knielsen/stm32f0_experiment_pcb/gerbers_rev1/pcb_f0test.txt

M48
;DRILL file {KiCad (2016-07-22 BZR 6991, Git 146a78a)-product} date Tue Jul 26 18:11:16 2016
;FORMAT={-:-/ absolute / inch / decimal}
FMAT,2
INCH,TZ
T1C0.012
T2C0.026
T3C0.028
T4C0.028
T5C0.031
T6C0.040
%
G90
G05
M72
T1
X1.169Y-1.9402
X1.1779Y-1.9802
X1.2283Y-0.8858
X1.2343Y-2.4047
X1.2463Y-2.083
X1.2464Y-1.7382
X1.2646Y-1.9784
X1.2663Y-1.9432
X1.2939Y-2.3753
X1.2953Y-1.1772
X1.2961Y-1.8431
X1.3305Y-2.3919
X1.378Y-1.252
X1.3937Y-0.9764
X1.3965Y-2.3731
X1.4047Y-2.5531
X1.4331Y-1.252
X1.4449Y-2.0512
X1.4582Y-2.5079
X1.4626Y-0.9645
X1.4646Y-1.1339
X1.4653Y-2.4752
X1.4744Y-2.5348
X1.4748Y-2.3744
X1.5056Y-2.3698
X1.5061Y-2.5536
X1.5392Y-2.4665
X1.5413Y-2.3636
X1.5433Y-2.5045
X1.561Y-2.5576
X1.5786Y-2.5026
X1.5797Y-2.3626
X1.5799Y-2.4309
X1.6004Y-2.5576
X1.6145Y-2.4279
X1.6808Y-2.484
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
