knielsen/stm32f0_experiment_pcb/pcb_f0test.kicad_pcb

## KiCad design pcb_f0test.kicad_pcb (2016-07-26)

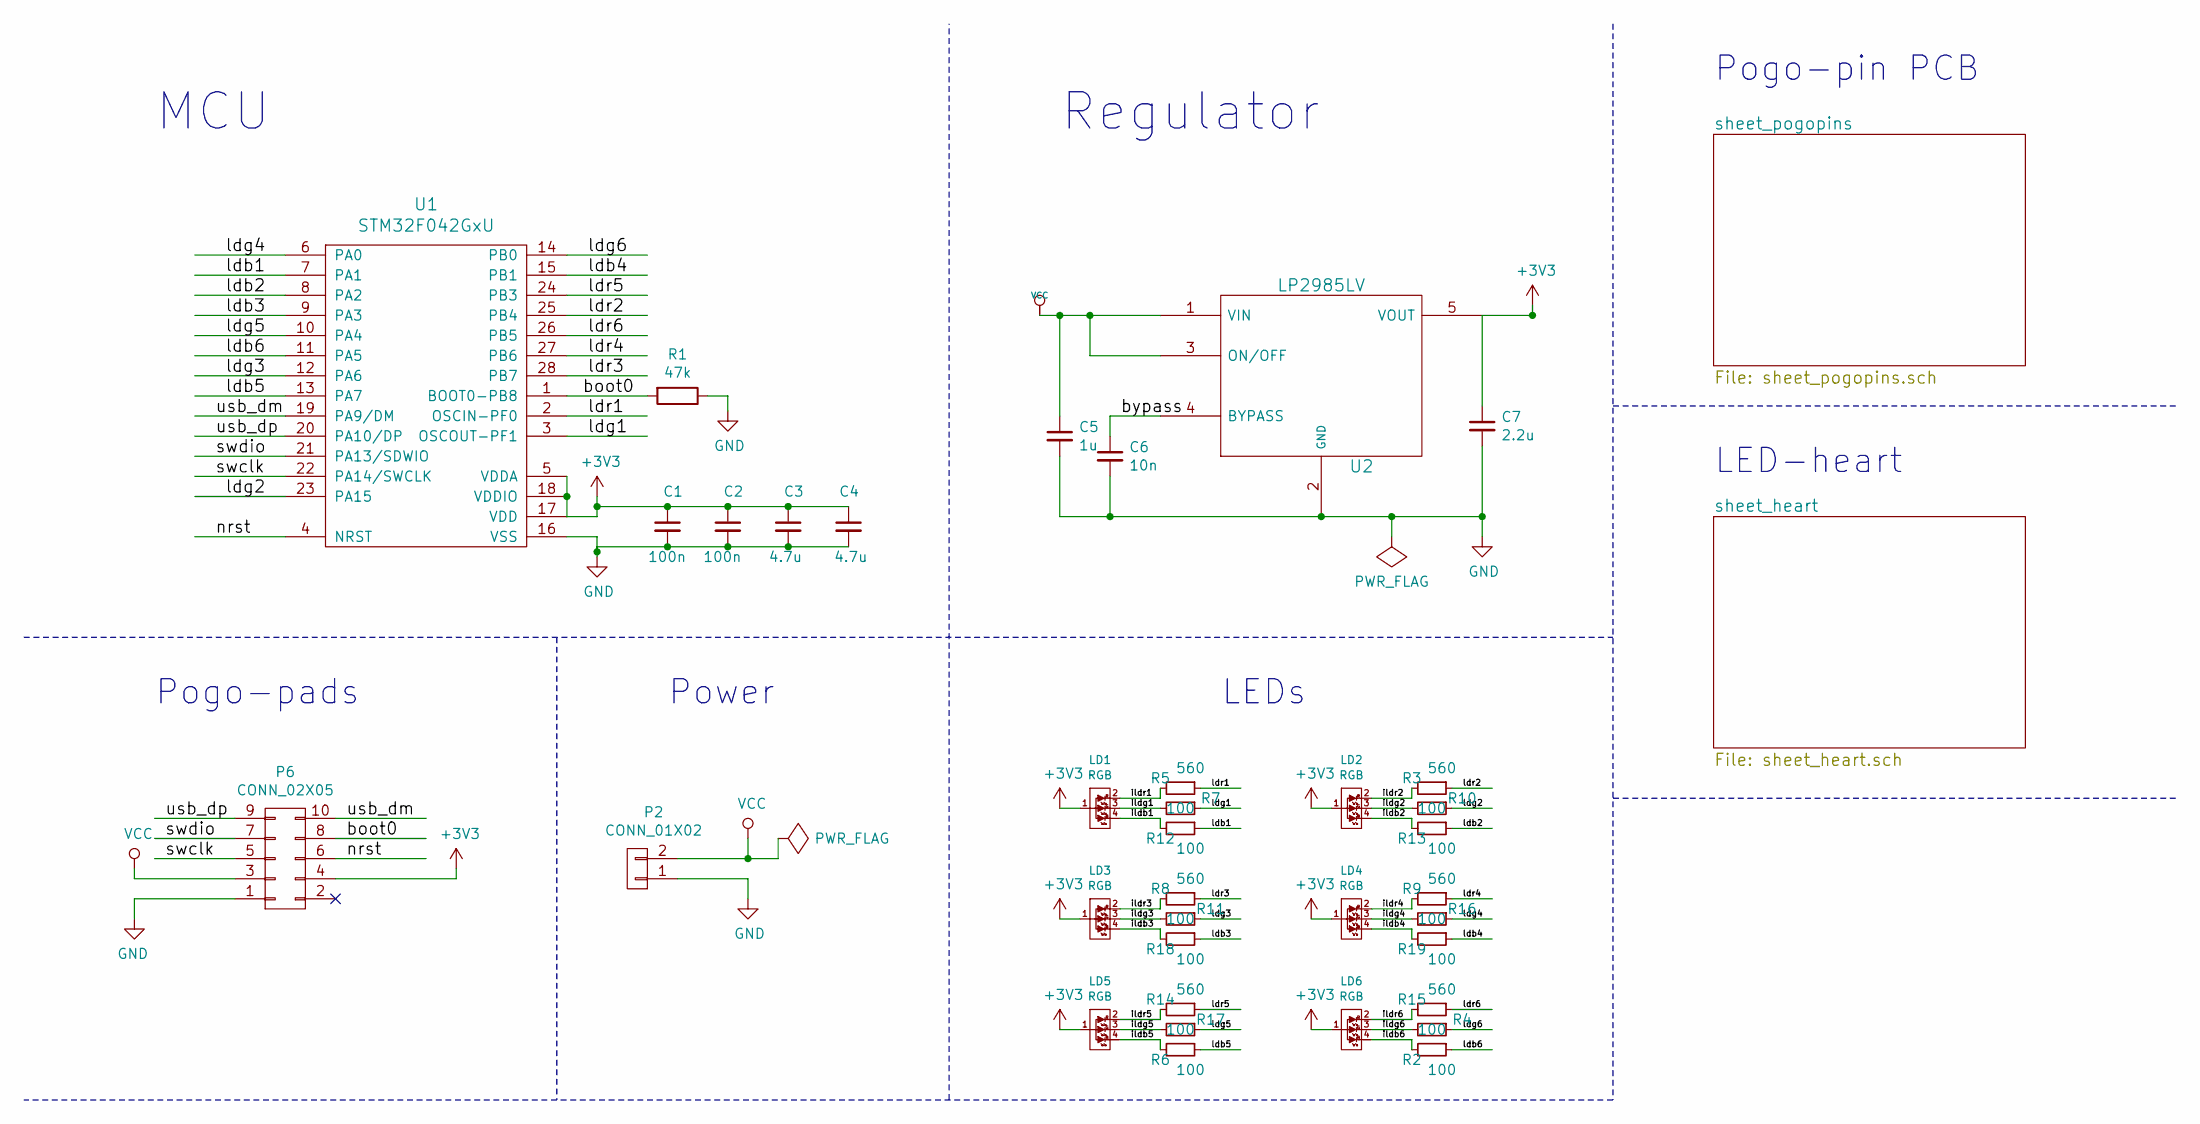
[picture p1: schematic pcb_f0test.sch]

Parts:
C1, C2: 100n; C_0603
C3, C4: 4.7u; C_0603
C5: 1u; C_0603
C6: 10n; C_0603
C7: 2.2u; C_0603
LD1, LD2, LD3, LD4, LD5, LD6: RGB; RGB_0603_ALTPINOUT
P2: CONN_01X02; Pin_Header_Straight_1x02
P6: CONN_02X05; pogopads_2x5_50mil_smd
R1: 47k; R_0603
R2, R4, R6, R7, R10, R11, R12, R13, R16, R17, R18, R19: 100; R_0603
R3, R5, R8, R9, R14, R15: 560; R_0603
U1: STM32F042GxU; UFQFPN28_fixpad
U2: LP2985LV; SOT-23-5

Connections:
+3V3: C1.1, C2.1, C3.1, C4.1, C7.1, LD1.1 (AG), LD2.1 (AG), LD3.1 (AG), LD4.1 (AG), LD5.1 (AG), LD6.1 (AG), P6.4, U1.5 (VDDA), U1.17 (VDD), U1.18 (VDDIO), U2.5 (VOUT)
/boot0: P6.8, R1.2, U1.1 (BOOT0-PB8)
/bypass: C6.1, U2.4 (BYPASS)
/ildb1: LD1.4 (R), R12.2
/ildb2: LD2.4 (R), R13.2
/ildb3: LD3.4 (R), R18.2
/ildb4: LD4.4 (R), R19.2
/ildb5: LD5.4 (R), R6.2
/ildb6: LD6.4 (R), R2.2
/ildg1: LD1.3 (R), R7.2
/ildg2: LD2.3 (R), R10.2
/ildg3: LD3.3 (R), R11.2
/ildg4: LD4.3 (R), R16.2
/ildg5: LD5.3 (R), R17.2
/ildg6: LD6.3 (R), R4.2
/ildr1: LD1.2 (R), R5.2
/ildr2: LD2.2 (R), R3.2
/ildr3: LD3.2 (R), R8.2
/ildr4: LD4.2 (R), R9.2
/ildr5: LD5.2 (R), R14.2
/ildr6: LD6.2 (R), R15.2
/ldb1: R12.1, U1.7 (PA1)
/ldb2: R13.1, U1.8 (PA2)
/ldb3: R18.1, U1.9 (PA3)
/ldb4: R19.1, U1.15 (PB1)
/ldb5: R6.1, U1.13 (PA7)
/ldb6: R2.1, U1.11 (PA5)
/ldg1: R7.1, U1.3 (OSCOUT-PF1)
/ldg2: R10.1, U1.23 (PA15)
/ldg3: R11.1, U1.12 (PA6)
/ldg4: R16.1, U1.6 (PA0)
/ldg5: R17.1, U1.10 (PA4)
/ldg6: R4.1, U1.14 (PB0)
/ldr1: R5.1, U1.2 (OSCIN-PF0)
/ldr2: R3.1, U1.25 (PB4)
/ldr3: R8.1, U1.28 (PB7)
/ldr4: R9.1, U1.27 (PB6)
/ldr5: R14.1, U1.24 (PB3)
/ldr6: R15.1, U1.26 (PB5)
/nrst: P6.6, U1.4 (NRST)
/swclk: P6.5, U1.22 (PA14/SWCLK)
/swdio: P6.7, U1.21 (PA13/SDWIO)
/usb_dm: P6.10, U1.19 (PA9/DM)
/usb_dp: P6.9, U1.20 (PA10/DP)
GND: C1.2, C2.2, C3.2, C4.2, C5.2, C6.2, C7.2, P2.1, P6.1, R1.1, U1.16 (VSS), U2.2 (GND)
VCC: C5.1, P2.2, P6.3, U2.1 (VIN), U2.3 (ON/OFF)

Notes on the sheet:
Pogo-pads
Power
LEDs
MCU
Regulator
Pogo-pin PCB
LED-heart

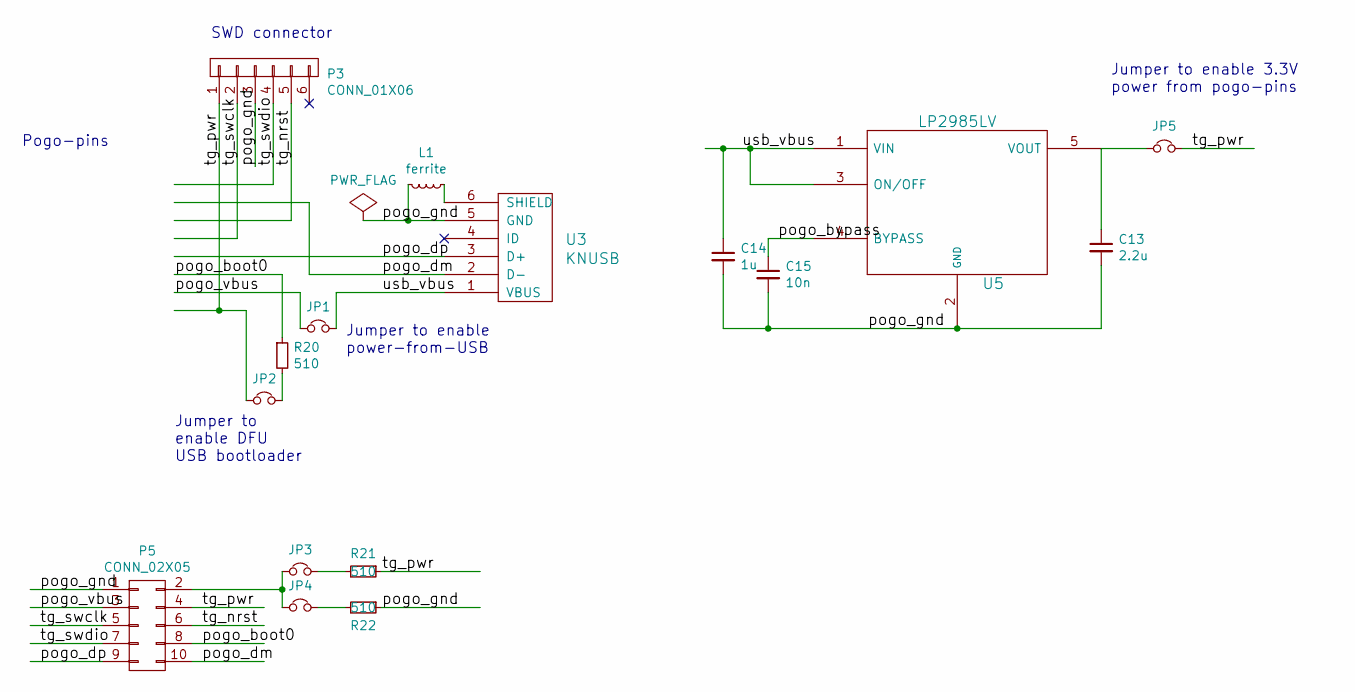
[picture p2: schematic sheet_pogopins.sch]

Parts:
C13: 2.2u; C_0603
C14: 1u; C_0603
C15: 10n; C_0603
JP1, JP2, JP3, JP4, JP5: Jumper_NC_Small; Pin_Header_Straight_1x02
L1: ferrite; R_0603_HandSoldering
P3: CONN_01X06; Pin_Header_Straight_1x06
P5: CONN_02X05; pogopins_2x5_50mil
R20, R21, R22: 510; R_0603
U3: KNUSB; 10103594-0001LF
U5: LP2985LV; SOT-23-5

Connections:
/sheet_pogopins/pogo_boot0: P5.8, R20.1
/sheet_pogopins/pogo_bypass: C15.1, U5.4 (BYPASS)
/sheet_pogopins/pogo_dm: P5.10, U3.2 (D-)
/sheet_pogopins/pogo_dp: P5.9, U3.3 (D+)
/sheet_pogopins/pogo_gnd: C13.2, C14.2, C15.2, L1.2, P3.3, P5.1, R22.1, U3.5 (GND), U5.2 (GND)
/sheet_pogopins/pogo_vbus: JP1.2, P5.3
/sheet_pogopins/tg_nrst: P3.5, P5.6
/sheet_pogopins/tg_pwr: JP2.1, JP5.2, P3.1, P5.4, R21.1
/sheet_pogopins/tg_swclk: P3.2, P5.5
/sheet_pogopins/tg_swdio: P3.4, P5.7
/sheet_pogopins/usb_vbus: C14.1, JP1.1, U3.1 (VBUS), U5.1 (VIN), U5.3 (ON/OFF)
unnamed: C13.1, JP5.1, U5.5 (VOUT)
unnamed: JP2.2, R20.2
unnamed: JP3.1, R21.2
unnamed: JP3.2, JP4.2, P5.2
unnamed: JP4.1, R22.2
unnamed: L1.1, U3.6 (SHIELD)

Notes on the sheet:
Jumper to enable DFU USB bootloader
Jumper to enable power-from-USB
SWD connector
Pogo-pins
Jumper to enable 3.3V power from pogo-pins

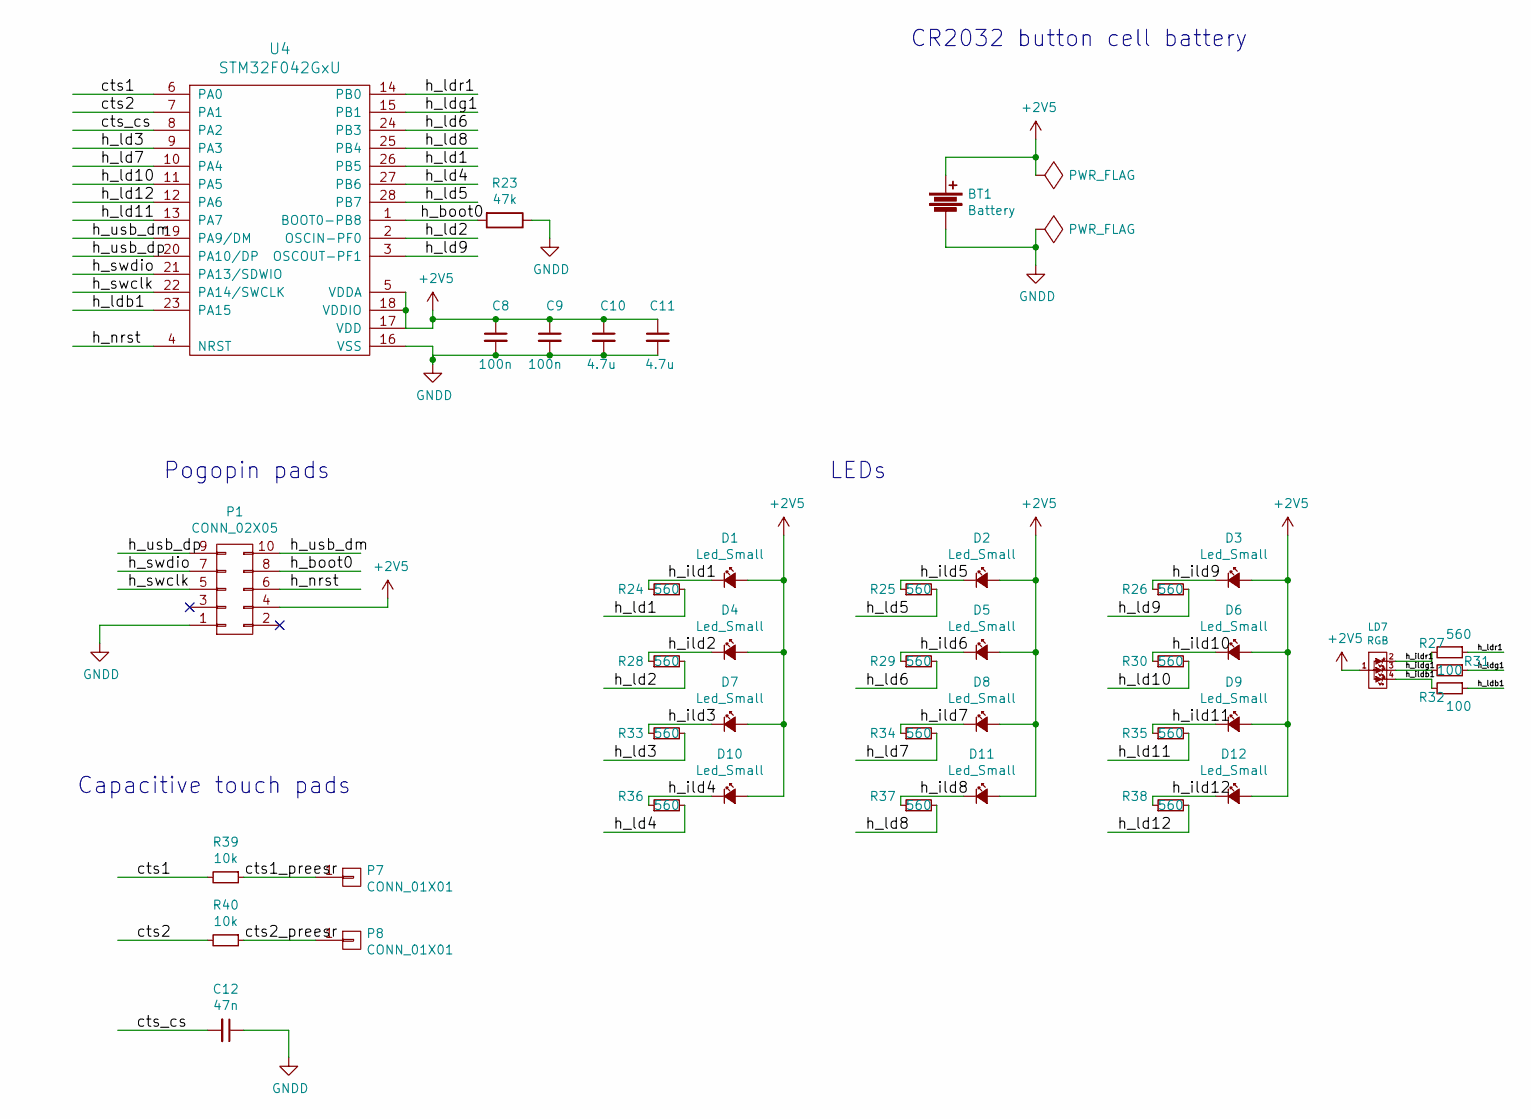
[picture p3: schematic sheet_heart.sch]

Parts:
BT1: Battery; Linx_BAT_HLD_001
C8, C9: 100n; C_0603
C10, C11: 4.7u; C_0603
C12: 47n; C_0603
D1, D2, D3, D4, D5, D6, D7, D8, D9, D10, D11, D12: Led_Small; LED_0603
LD7: RGB; RGB_0603_ALTPINOUT
P1: CONN_02X05; pogopads_2x5_50mil_smd
P7, P8: CONN_01X01; Touchpad_8mm
R23: 47k; R_0603
R24, R25, R26, R27, R28, R29, R30, R33, R34, R35, R36, R37, R38: 560; R_0603
R31, R32: 100; R_0603
R39, R40: 10k; R_0603
U4: STM32F042GxU; UFQFPN28_fixpad

Connections:
+2V5: BT1.1, C8.1, C9.1, C10.1, C11.1, D1.2 (A), D2.2 (A), D3.2 (A), D4.2 (A), D5.2 (A), D6.2 (A), D7.2 (A), D8.2 (A), D9.2 (A), D10.2 (A), D11.2 (A), D12.2 (A), LD7.1 (AG), P1.4, U4.5 (VDDA), U4.17 (VDD), U4.18 (VDDIO)
/sheet_heart/cts1: R39.2, U4.6 (PA0)
/sheet_heart/cts1_preesr: P7.1, R39.1
/sheet_heart/cts2: R40.2, U4.7 (PA1)
/sheet_heart/cts2_preesr: P8.1, R40.1
/sheet_heart/cts_cs: C12.2, U4.8 (PA2)
/sheet_heart/h_boot0: P1.8, R23.2, U4.1 (BOOT0-PB8)
/sheet_heart/h_ild1: D1.1 (K), R24.1
/sheet_heart/h_ild2: D4.1 (K), R28.1
/sheet_heart/h_ild3: D7.1 (K), R33.1
/sheet_heart/h_ild4: D10.1 (K), R36.1
/sheet_heart/h_ild5: D2.1 (K), R25.1
/sheet_heart/h_ild6: D5.1 (K), R29.1
/sheet_heart/h_ild7: D8.1 (K), R34.1
/sheet_heart/h_ild8: D11.1 (K), R37.1
/sheet_heart/h_ild9: D3.1 (K), R26.1
/sheet_heart/h_ild10: D6.1 (K), R30.1
/sheet_heart/h_ild11: D9.1 (K), R35.1
/sheet_heart/h_ild12: D12.1 (K), R38.1
/sheet_heart/h_ildb1: LD7.4 (R), R32.2
/sheet_heart/h_ildg1: LD7.3 (R), R31.2
/sheet_heart/h_ildr1: LD7.2 (R), R27.2
/sheet_heart/h_ld1: R24.2, U4.26 (PB5)
/sheet_heart/h_ld2: R28.2, U4.2 (OSCIN-PF0)
/sheet_heart/h_ld3: R33.2, U4.9 (PA3)
/sheet_heart/h_ld4: R36.2, U4.27 (PB6)
/sheet_heart/h_ld5: R25.2, U4.28 (PB7)
/sheet_heart/h_ld6: R29.2, U4.24 (PB3)
/sheet_heart/h_ld7: R34.2, U4.10 (PA4)
/sheet_heart/h_ld8: R37.2, U4.25 (PB4)
/sheet_heart/h_ld9: R26.2, U4.3 (OSCOUT-PF1)
/sheet_heart/h_ld10: R30.2, U4.11 (PA5)
/sheet_heart/h_ld11: R35.2, U4.13 (PA7)
/sheet_heart/h_ld12: R38.2, U4.12 (PA6)
/sheet_heart/h_ldb1: R32.1, U4.23 (PA15)
/sheet_heart/h_ldg1: R31.1, U4.15 (PB1)
/sheet_heart/h_ldr1: R27.1, U4.14 (PB0)
/sheet_heart/h_nrst: P1.6, U4.4 (NRST)
/sheet_heart/h_swclk: P1.5, U4.22 (PA14/SWCLK)
/sheet_heart/h_swdio: P1.7, U4.21 (PA13/SDWIO)
/sheet_heart/h_usb_dm: P1.10, U4.19 (PA9/DM)
/sheet_heart/h_usb_dp: P1.9, U4.20 (PA10/DP)
GNDD: BT1.2, C8.2, C9.2, C10.2, C11.2, C12.1, P1.1, R23.1, U4.16 (VSS)

Notes on the sheet:
Capacitive touch pads
CR2032 button cell battery
Pogopin pads
LEDs

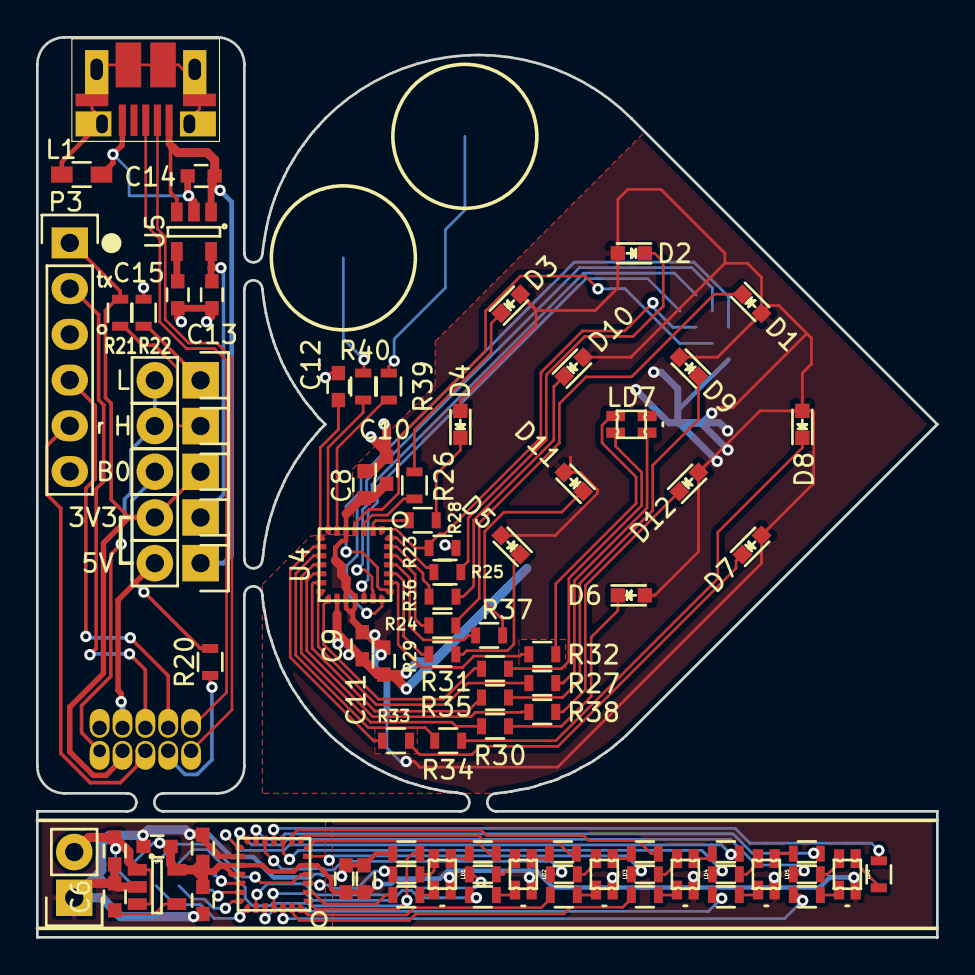
[picture p4: board pcb_f0test.kicad_pcb from above]

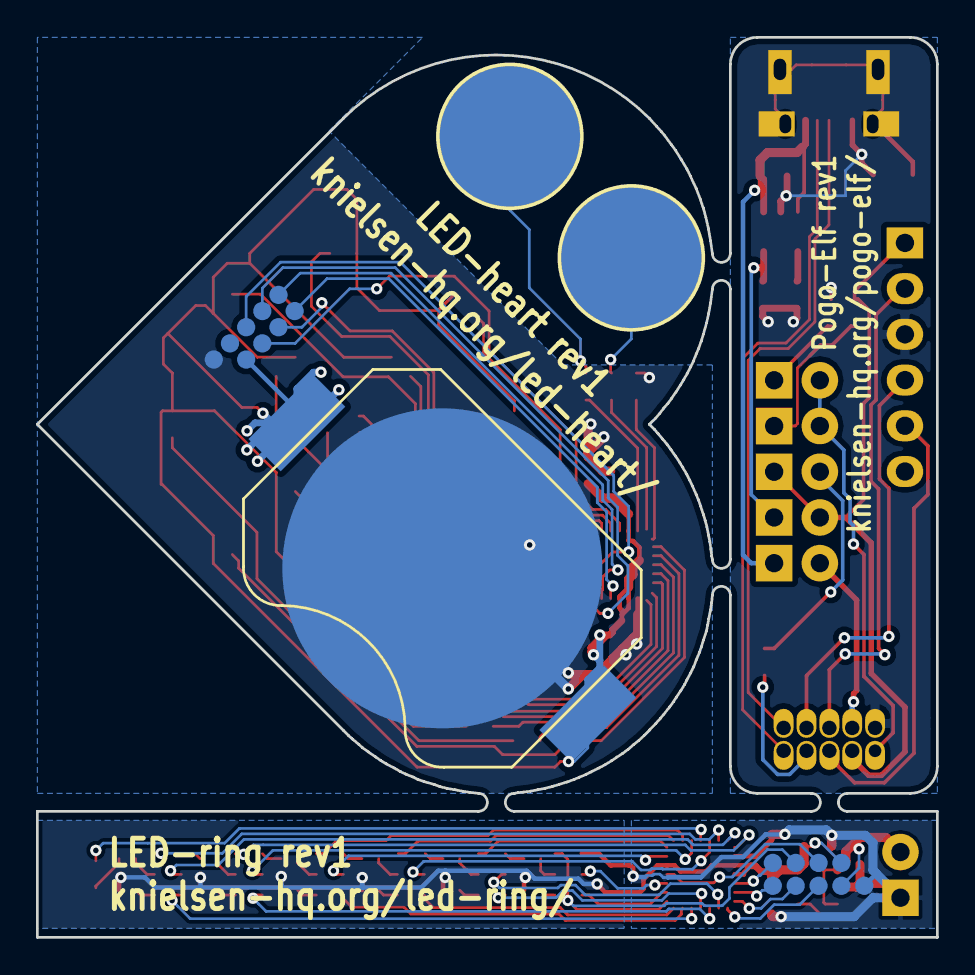
[picture p5: board pcb_f0test.kicad_pcb from below]

Board: 2 copper layers, 50.0 x 50.0 mm, 93 parts (5 on the bottom side), 106 nets.
