knielsen/stm32f0_experiment_pcb/(commit log)

2016-06-22 Initial routing; still needs to be tweaked a bit.
    [pcb_f0test.kicad_pcb, pcb_f0test.sch]
2016-06-22 Fairly good routing now.
    [pcb_f0test.kicad_pcb]
2016-06-24 Some misc. changes.
    [pcb_f0test.kicad_pcb]
2016-06-26 Fix corner pads on QFN.
    [pcb_f0test.kicad_pcb]
2016-06-26 Fix numbering of LEDs.
    [pcb_f0test.kicad_pcb, pcb_f0test.sch]
2016-06-29 Add pogopin board, fixing pogopad layout.
    [pcb_f0test.kicad_pcb, pcb_f0test.sch, sheet_pogopins.sch]
2016-07-04 Initial stab at a "christmas heart" decoration pcb.
    [pcb_f0test.kicad_pcb, pcb_f0test.sch, sheet_heart.sch, sheet_pogopins.sch]
2016-07-05 Fix PCB outline (might still need a bit of tweaks for the ring).
    [pcb_f0test.kicad_pcb]
2016-07-05 Improved routing of the heart.
    [pcb_f0test.kicad_pcb]
2016-07-06 Routing cleanup and silkscreen on heart.
    [pcb_f0test.kicad_pcb, sheet_heart.sch, sheet_pogopins.sch]
2016-07-07 Tweak outline of ring PCB.
    [pcb_f0test.kicad_pcb]
2016-07-07 New routing of pogo-pins board (still needs some cleanup).
    [pcb_f0test.kicad_pcb, sheet_pogopins.sch]
2016-07-08 Cleanup routing on pogo-pins pcb, looks good now.
    [pcb_f0test.kicad_pcb]
2016-07-08 Silkscreen and cleanup.
    [pcb_f0test.kicad_pcb]
2016-07-08 More silk screen, getting pretty close now, I think.
    [pcb_f0test.kicad_pcb]
2016-07-16 Only minor changes, if any.
    [pcb_f0test.kicad_pcb, pcb_f0test.sch, sheet_heart.sch, sheet_pogopins.sch]
2016-07-16 Switch RGB LED on heart PCB to new type/pinout.
    [pcb_f0test.kicad_pcb]
2016-07-17 Change RGB LED footprint to match new batch of cheap 0603.
    [pcb_f0test.kicad_pcb, pcb_f0test.sch, sheet_heart.sch]
2016-07-26 Final gerbers for rev1.
    [pcb_f0test.kicad_pcb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]
